miyayue/dionisio-vortex/placa/placa.kicad_pcb

## KiCad design placa/placa.kicad_pcb (2026-11-05)

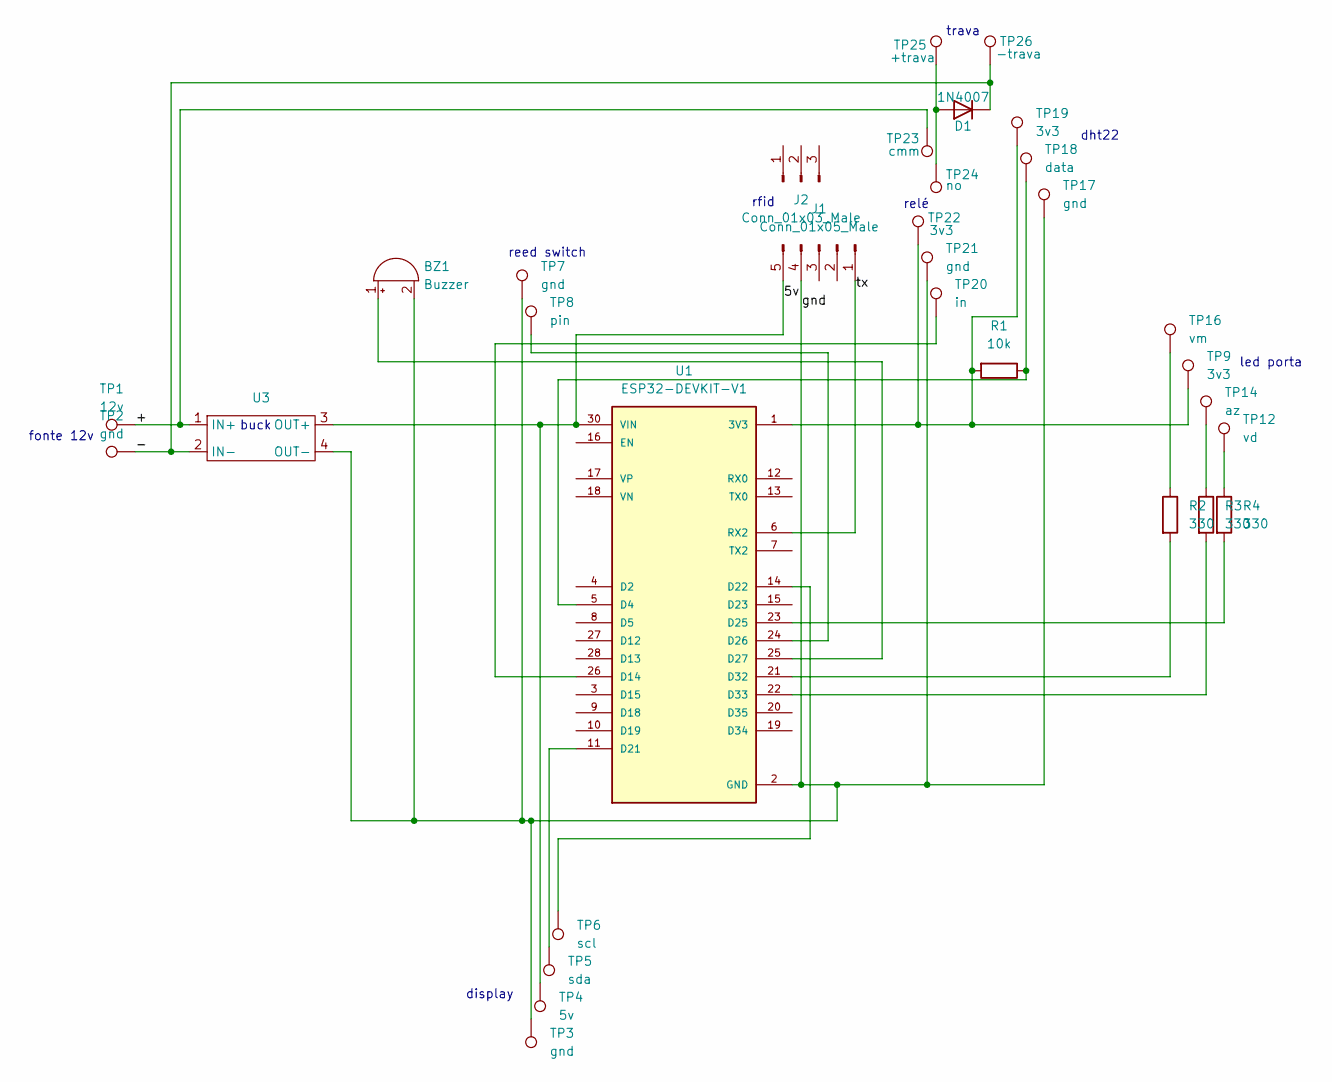
[picture p15: schematic placa.kicad_sch]

Parts:
BZ1: Buzzer; Buzzer_12x9.5RM7.6
D1: 1N4007; D_DO-41_SOD81_P10.16mm_Horizontal
J1: Conn_01x05_Male; PinSocket_1x05_P2.54mm_Vertical
J2: Conn_01x03_Male; PinSocket_1x03_P2.54mm_Vertical
R1: 10k; R_Axial_DIN0207_L6.3mm_D2.5mm_P7.62mm_Horizontal
R2, R3, R4: 330; R_Axial_DIN0207_L6.3mm_D2.5mm_P7.62mm_Horizontal
TP1: 12v; TestPoint_Pad_D3.0mm
TP2, TP3, TP7, TP17, TP21: gnd; TestPoint_Pad_D3.0mm
TP4: 5v; TestPoint_Pad_D3.0mm
TP5: sda; TestPoint_Pad_D3.0mm
TP6: scl; TestPoint_Pad_D3.0mm
TP8: pin; TestPoint_Pad_D3.0mm
TP9, TP19, TP22: 3v3; TestPoint_Pad_D3.0mm
TP12: vd; TestPoint_Pad_D3.0mm
TP14: az; TestPoint_Pad_D3.0mm
TP16: vm; TestPoint_Pad_D3.0mm
TP18: data; TestPoint_Pad_D3.0mm
TP20: in; TestPoint_Pad_D3.0mm
TP23: cmm; TestPoint_Pad_D3.0mm
TP24: no; TestPoint_Pad_D3.0mm
TP25: +trava; TestPoint_Pad_D3.0mm
TP26: -trava; TestPoint_Pad_D3.0mm
U1: ESP32-DEVKIT-V1; MODULE_ESP32_DEVKIT_V1; PARTREV N/A
U3: zk-qc-mini

Connections:
/5v: J1.5, TP4.1 (1_1), U1.30 (VIN), U3.3 (OUT+)
/+: TP1.1 (1_1), TP23.1 (1_1), U3.1 (IN+)
/-: D1.1 (K), TP2.1 (1_1), TP26.1 (1_1), U3.2 (IN-)
/tx: J1.1, U1.6 (RX2)
GND: BZ1.2 (+), J1.4, TP3.1 (1_1), TP7.1 (1_1), TP17.1 (1_1), TP21.1 (1_1), U1.2 (GND), U1.29 (GND), U3.4 (OUT-)
unnamed: BZ1.1 (-), U1.25 (D27)
unnamed: D1.2 (A), TP24.1 (1_1), TP25.1 (1_1)
unnamed: R2.1, TP16.1 (1_1)
unnamed: R3.1, TP14.1 (1_1)
unnamed: R4.1, TP12.1 (1_1)
unnamed: R1.2, TP9.1 (1_1), TP19.1 (1_1), TP22.1 (1_1), U1.1 (3V3)
unnamed: R1.1, TP18.1 (1_1), U1.5 (D4)
unnamed: TP20.1 (1_1), U1.26 (D14)
unnamed: TP5.1 (1_1), U1.11 (D21)
unnamed: TP6.1 (1_1), U1.14 (D22)
unnamed: R4.2, U1.23 (D25)
unnamed: TP8.1 (1_1), U1.24 (D26)
unnamed: R2.2, U1.21 (D32)
unnamed: R3.2, U1.22 (D33)

Notes on the sheet:
led porta
buck
fonte 12v
rfid
dht22
trava
relé
display
reed switch

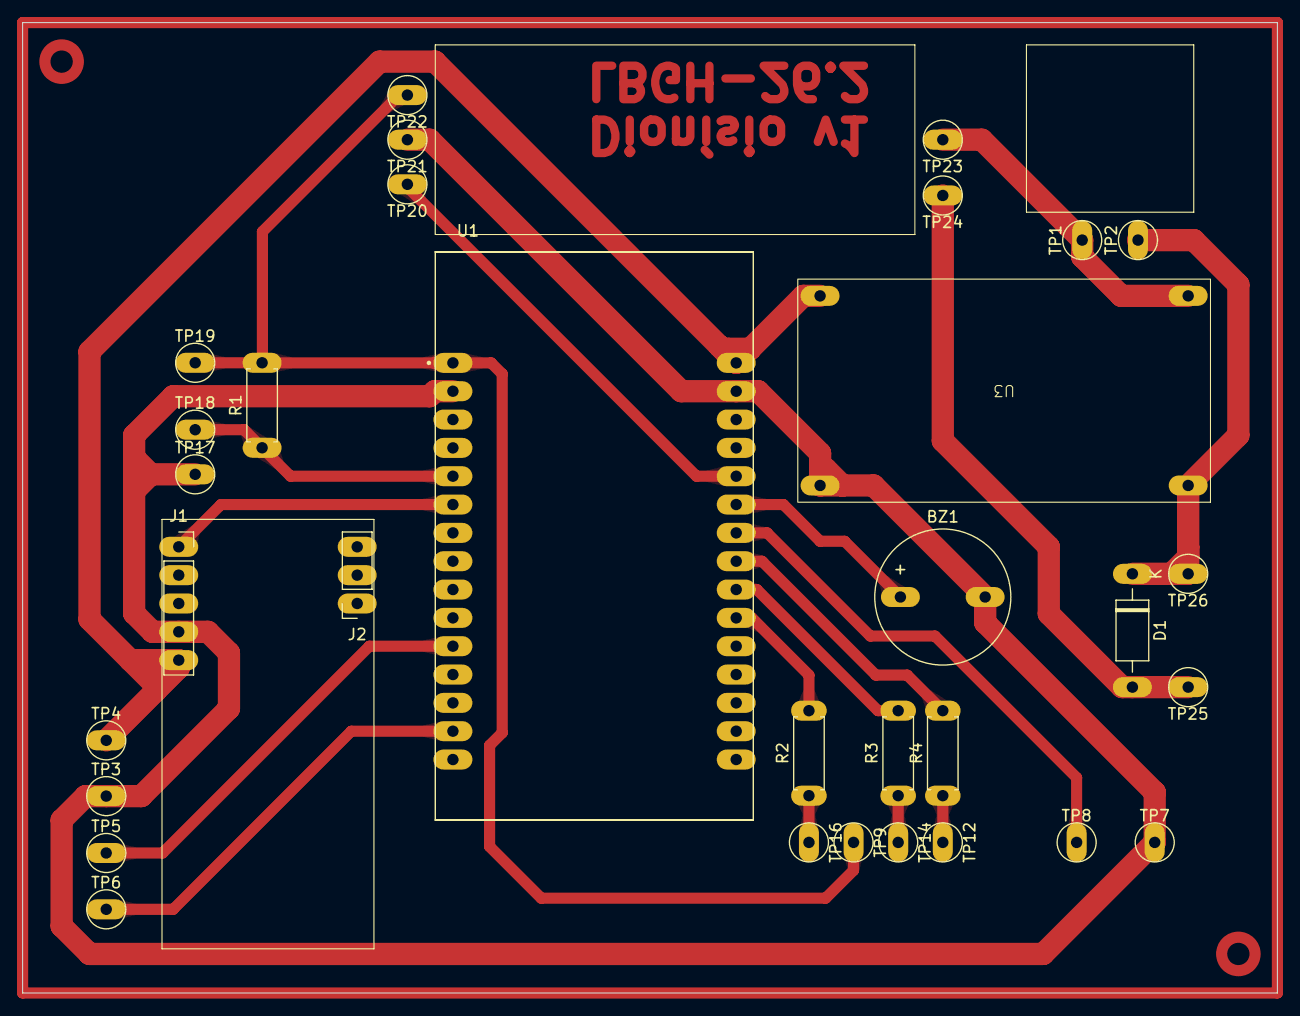
[picture p16: board placa.kicad_pcb from above]

Board: 2 copper layers, 112.5 x 87.0 mm, 32 parts (0 on the bottom side), 19 nets.
