miyayue/dionisio-vortex/(commit log)

2026-10-21 dht and led test
2026-10-26 reed switch
2026-10-26 fixes + visual feedback
    [main.cpp]
2026-10-28 bkp + refactor + new led pins
2026-10-28 buzz pin i forgo
    [main.cpp]
2026-11-02 the start of a dream (everything went wrong
    [placa.kicad_pcb, placa.kicad_sch]
2026-11-03 board wip
    [placa.kicad_pcb, placa.kicad_sch]
2026-11-04 board with fixes
    [placa.kicad_pcb]
2026-11-04 update pins
    [placa.kicad_pcb]
2026-11-05 more board fixes
    [placa.kicad_pcb]
2026-11-05 final board
    [placa.kicad_pcb]
2026-11-05 small code changes + todo notes to help with fixes
    [main.cpp]
2026-11-05 add organization notes + kanban board
